PaoloJN/sensei-puck/hardware/sensei-puck/sensei-puck.kicad_pcb

## KiCad design hardware/sensei-puck/sensei-puck.kicad_pcb (2026-10-24)

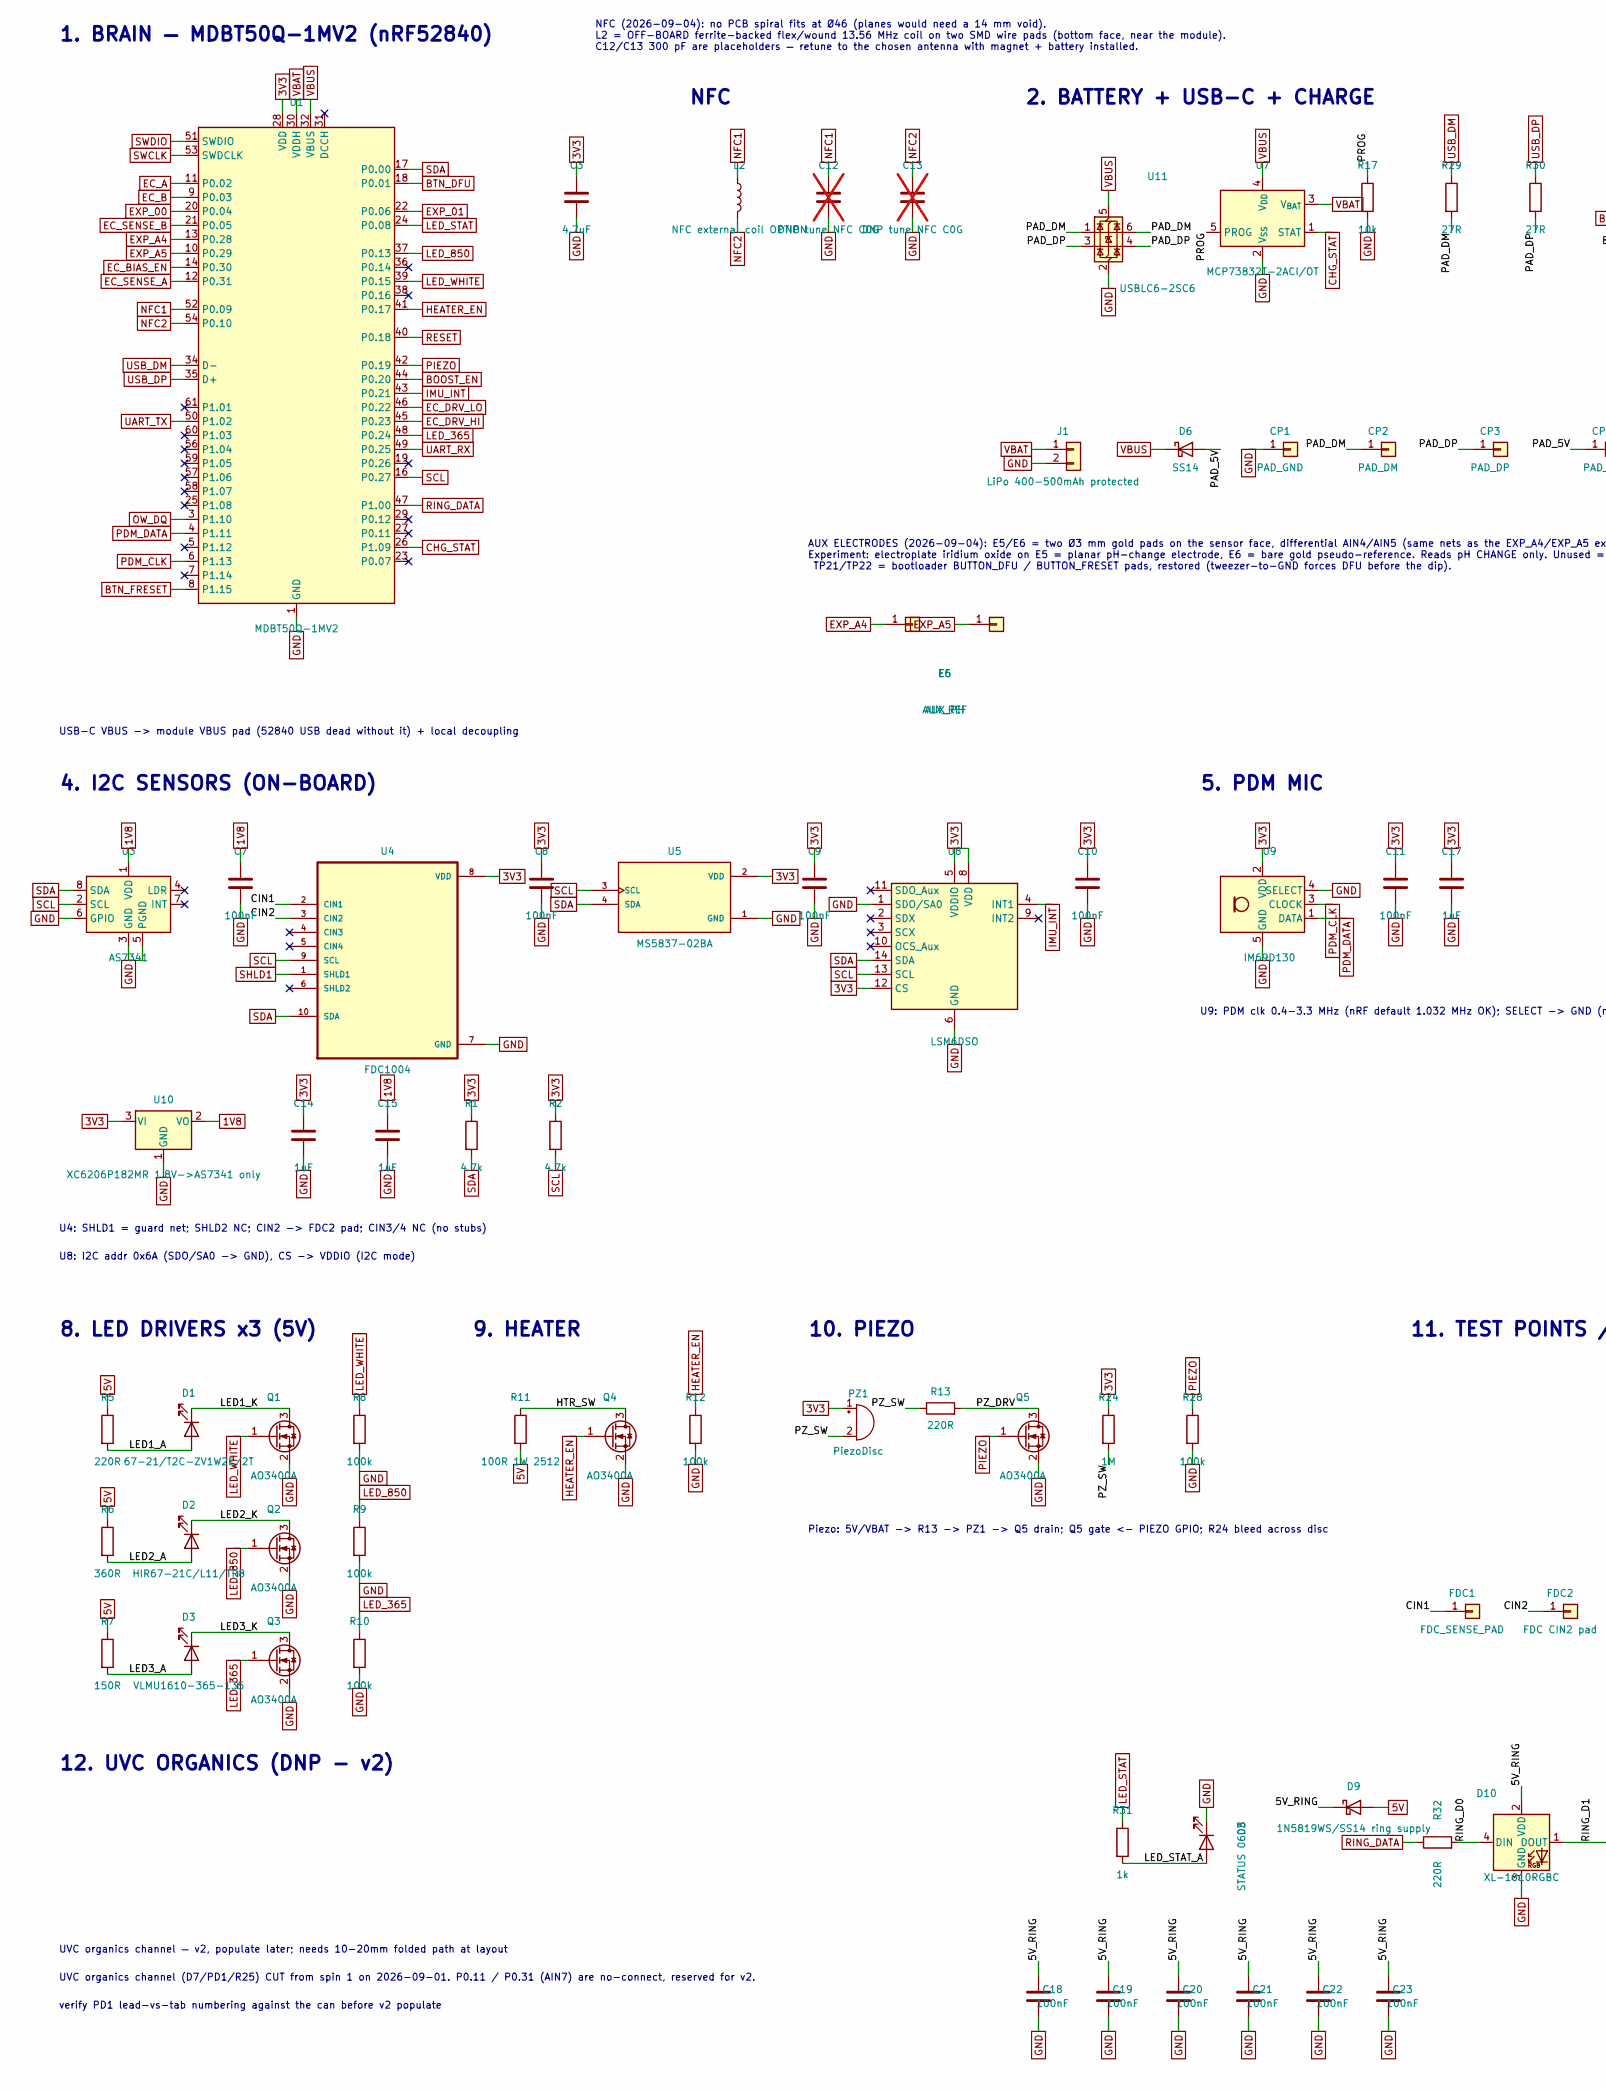
[picture p6: schematic sensei-puck.kicad_sch, part in row 1, column 1]

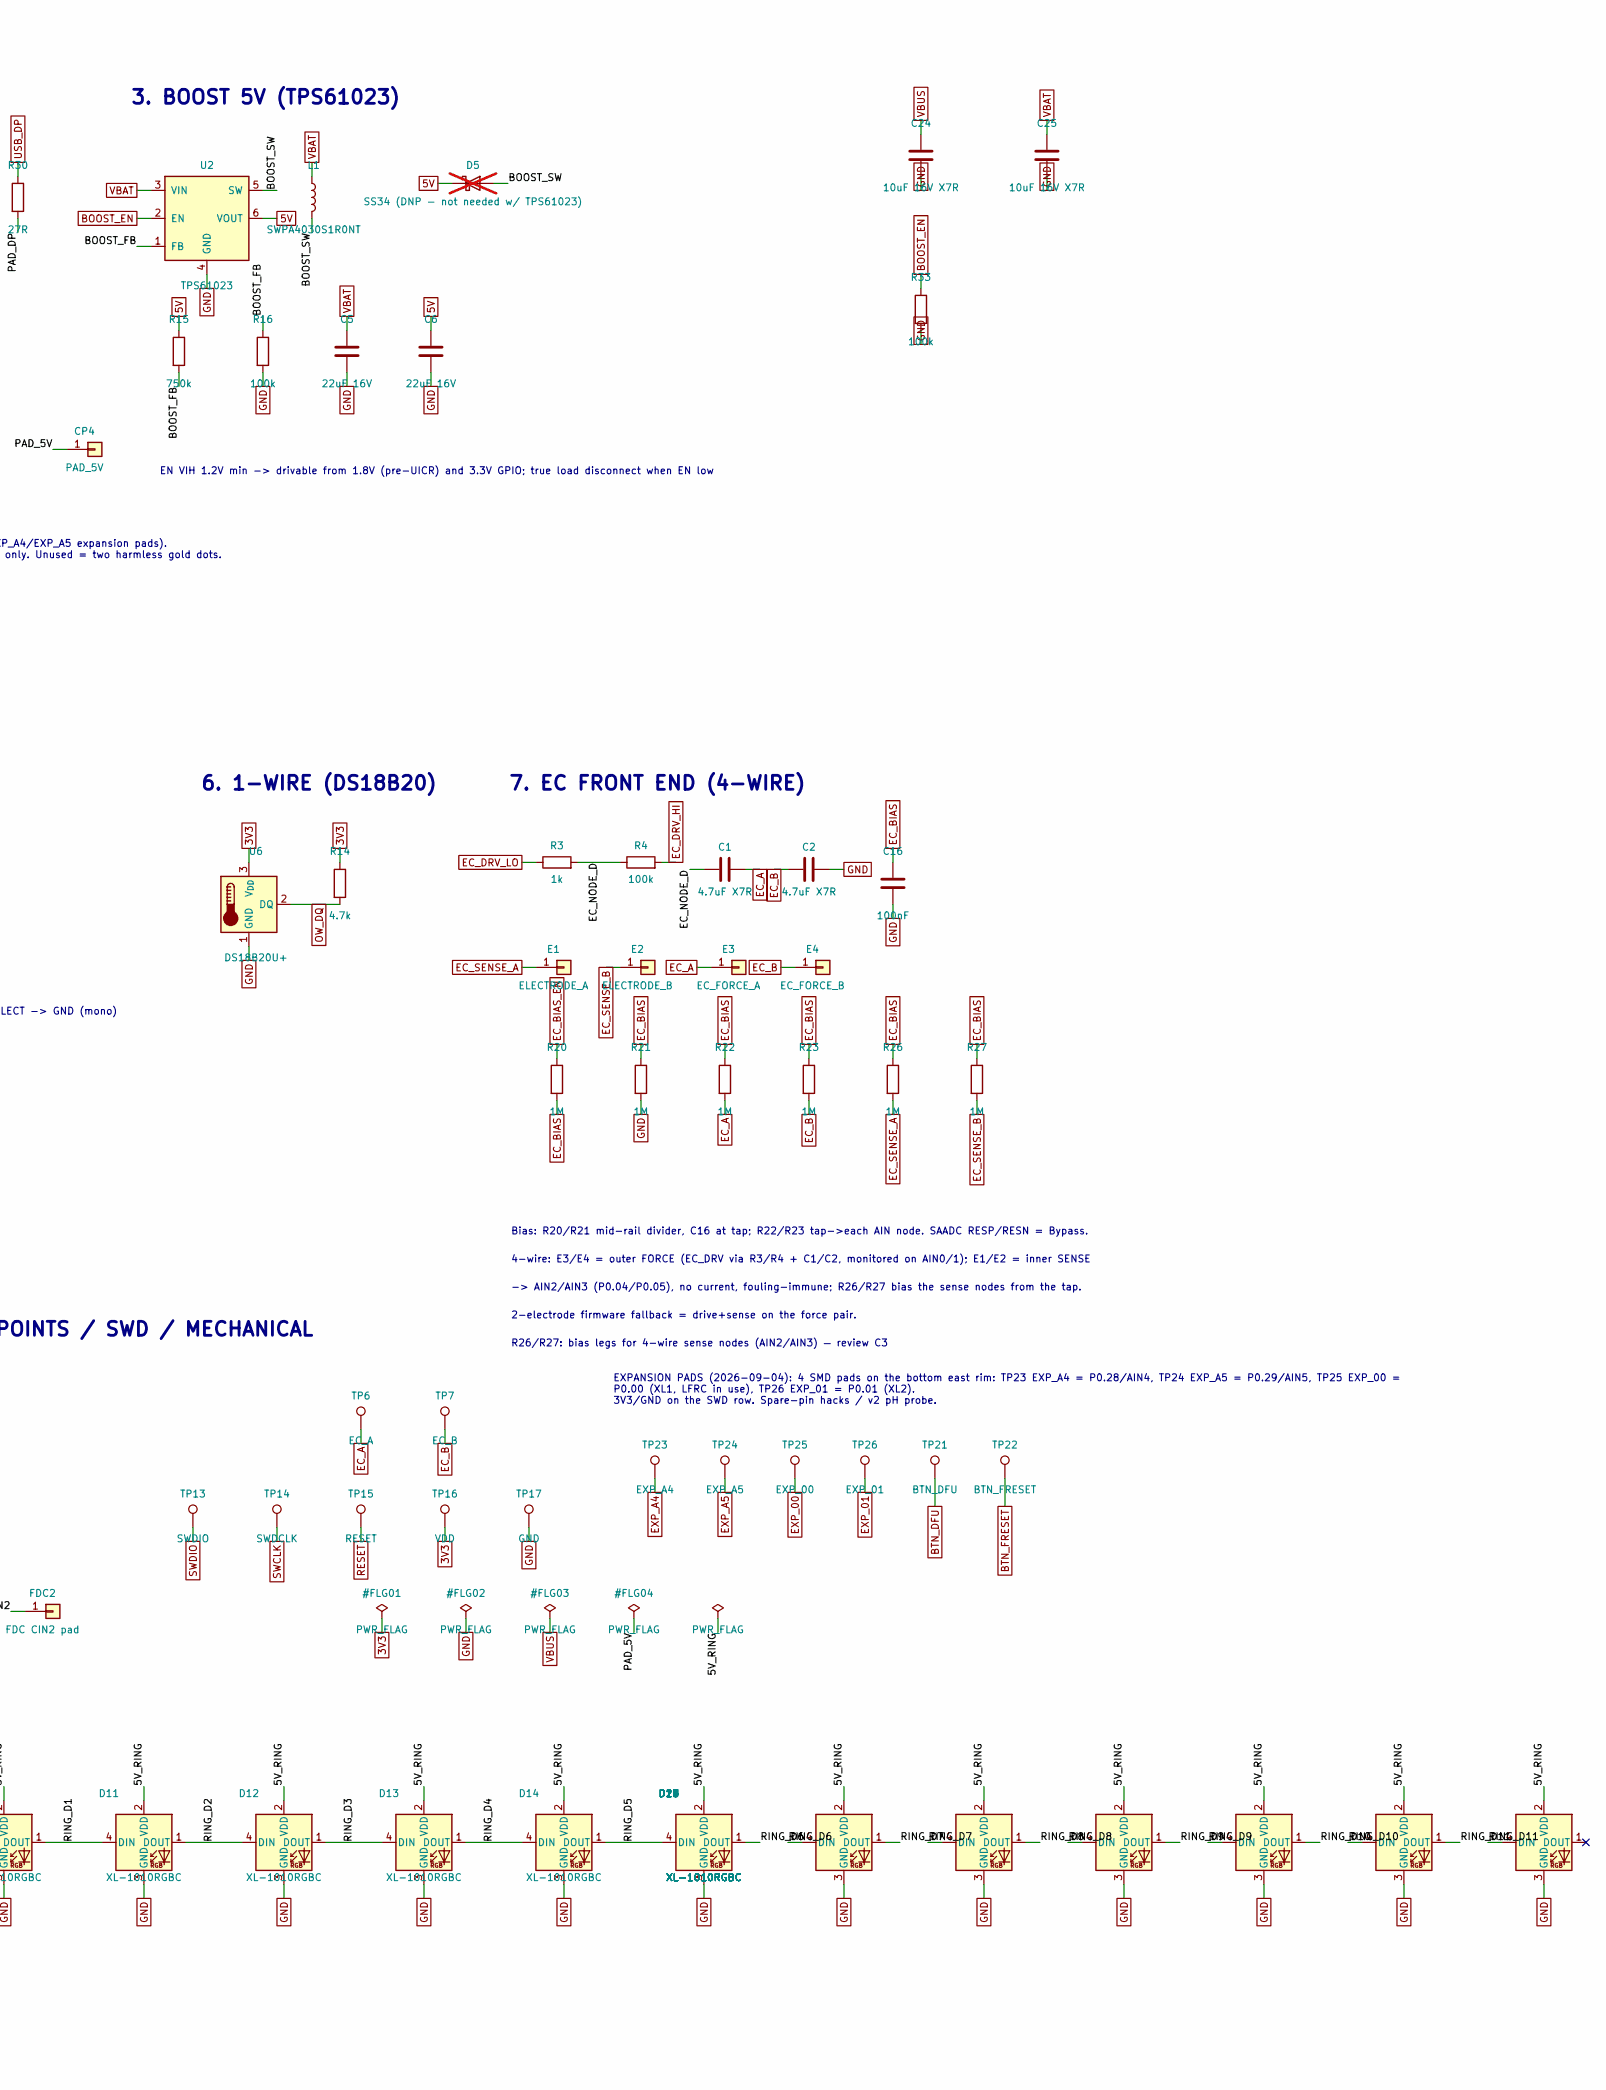
[picture p7: schematic sensei-puck.kicad_sch, part in row 1, column 2]

Parts:
C1, C2: 4.7uF X7R; C_0805_2012Metric_Pad1.18x1.45mm_HandSolder
C3: 4.7uF; C_0805_2012Metric
C5, C6: 22uF 16V; C_0805_2012Metric_Pad1.18x1.45mm_HandSolder
C7, C8, C9, C10, C11, C16, C18, C19, C20, C21, C22, C23: 100nF; C_0402_1005Metric
C12, C13: DNP tune NFC C0G; C_0402_1005Metric; not fitted
C14, C15, C17: 1uF; C_0402_1005Metric
C24, C25: 10uF 16V X7R; C_1206_3216Metric
CP1: PAD_GND; CHG_Pad_D2.0mm
CP2: PAD_DM; CHG_Pad_D2.0mm
CP3: PAD_DP; CHG_Pad_D2.0mm
CP4: PAD_5V; CHG_Pad_D2.0mm
D1: 67-21/T2C-ZV1W2E/2T; LED_Everlight_67-21_PLCC2
D2: HIR67-21C/L11/TR8; LED_Everlight_67-21_PLCC2
D3: VLMU1610-365-135; LED_Vishay_VLMU1610
D5: SS34 (DNP - not needed w/ TPS61023); D_SMA; not fitted
D6: SS14; D_SOD-123
D8: STATUS 0603; LED_0603_1608Metric
D9: 1N5819WS/SS14 ring supply; D_SOD-123
D10, D11, D12, D13, D14, D15, D16, D17, D18, D19, D20, D21: XL-1010RGBC; LED_XL-1010RGBC
E1: ELECTRODE_A; EC_Electrode_2x8mm
E2: ELECTRODE_B; EC_Electrode_2x8mm
E3: EC_FORCE_A; EC_Electrode_2x8mm
E4: EC_FORCE_B; EC_Electrode_2x8mm
E5: AUX_PH; AUX_Pad_D3.0mm
E6: AUX_REF; AUX_Pad_D3.0mm
FDC1: FDC_SENSE_PAD; FDC_Sense_Pad_D7.9mm
FDC2: FDC CIN2 pad; FDC_Sense_Ring_D10-12.8mm
J1: LiPo 400-500mAh protected; JST_PH_S2B-PH-K_1x02_P2.00mm_Horizontal
L1: SWPA4030S1R0NT; L_Sunlord_SWPA4030S
L2: NFC external coil OPTION; WirePad_1x02_SMD_1.5x3mm
PZ1: PiezoDisc; PZ_WirePad_1x02_SMD
Q1, Q2, Q3, Q4, Q5: AO3400A; SOT-23
R1, R2, R14: 4.7k; R_0402_1005Metric
R3, R31: 1k; R_0402_1005Metric
R4, R8, R9, R10, R12, R16, R28, R33: 100k; R_0402_1005Metric
R5, R13, R32: 220R; R_0402_1005Metric
R6: 360R; R_0402_1005Metric
R7: 150R; R_0402_1005Metric
R11: 100R 1W 2512; R_2512_6332Metric_Pad1.40x3.35mm_HandSolder
R15: 750k; R_0402_1005Metric
R17: 10k; R_0402_1005Metric
R20, R21, R22, R23, R24, R26, R27: 1M; R_0402_1005Metric
R29, R30: 27R; R_0402_1005Metric
TP6: EC_A; TestPoint_Pad_D1.5mm
TP7: EC_B; TestPoint_Pad_D1.5mm
TP13: SWDIO; TestPoint_Pad_D1.5mm
TP14: SWDCLK; TestPoint_Pad_D1.5mm
TP15: RESET; TestPoint_Pad_D1.5mm
TP16: VDD; TestPoint_Pad_D1.5mm
TP17: GND; TestPoint_Pad_D1.5mm
TP21: BTN_DFU; ExpPad_1.2x2.2mm
TP22: BTN_FRESET; ExpPad_1.2x2.2mm
TP23: EXP_A4; ExpPad_1.2x2.2mm
TP24: EXP_A5; ExpPad_1.2x2.2mm
TP25: EXP_00; ExpPad_1.2x2.2mm
TP26: EXP_01; ExpPad_1.2x2.2mm
U1: MDBT50Q-1MV2
U2: TPS61023; SOT-563
U3: AS7341; AMS_OLGA-8_2x3.1mm_P0.8mm
U4: FDC1004; SOP50P490X110-10N
U5: MS5837-02BA; XDCR_MS583702BA01-50
U6: DS18B20U+; DS18B20U_MSOP8
U7: MCP73832T-2ACI/OT; SOT-23-5
U8: LSM6DSO; LGA-14_3x2.5mm_P0.5mm_LayoutBorder3x4y
U9: IM69D130; Infineon_PG-LLGA-5-1
U10: XC6206P182MR 1.8V->AS7341 only; SOT-23
U11: USBLC6-2SC6; SOT-23-6

Connections:
1V8: C7.1, C15.1, U3.1 (VDD), U10.2 (VO)
3V3: C3.1, C8.1, C9.1, C10.1, C11.1, C14.1, C17.1, PZ1.1 (+), R1.1, R2.1, R14.1, R24.1, TP16.1 (1_1), U1.28 (VDD), U4.8 (VDD), U5.2 (VDD), U6.3 (V_{DD}), U8.5 (VDDIO), U8.8 (VDD), U8.12 (CS), U9.2 (VDD), U10.3 (VI)
5V: C6.1, D5.1 (K), D9.2 (A), R5.1, R6.1, R7.1, R11.2, R15.1, U2.6 (VOUT)
/5V_RING: C18.1, C19.1, C20.1, C21.1, C22.1, C23.1, D9.1 (K), D10.2 (VDD), D11.2 (VDD), D12.2 (VDD), D13.2 (VDD), D14.2 (VDD), D15.2 (VDD), D16.2 (VDD), D17.2 (VDD), D18.2 (VDD), D19.2 (VDD), D20.2 (VDD), D21.2 (VDD)
/BOOST_FB: R15.2, R16.1, U2.1 (FB)
/BOOST_SW: D5.2 (A), L1.2, U2.5 (SW)
/CIN1: FDC1.1 (Pin_1_1), U4.2 (CIN1)
/CIN2: FDC2.1 (Pin_1_1), U4.3 (CIN2)
/EC_NODE_D: C1.1, R3.2, R4.1
/HTR_SW: Q4.3 (D), R11.1
/LED1_A: D1.2 (A), R5.2
/LED1_K: D1.1 (K), Q1.3 (D)
/LED2_A: D2.2 (A), R6.2
/LED2_K: D2.1 (K), Q2.3 (D)
/LED3_A: D3.2 (A), R7.2
/LED3_K: D3.1 (K), Q3.3 (D)
/LED_STAT_A: D8.2 (A), R31.2
/PAD_5V: CP4.1 (Pin_1_1), D6.2 (A)
/PAD_DM: CP2.1 (Pin_1_1), R29.2, U11.1 (I/O1), U11.6 (I/O1)
/PAD_DP: CP3.1 (Pin_1_1), R30.2, U11.3 (I/O2), U11.4 (I/O2)
/PROG: R17.1, U7.5 (PROG)
/PZ_DRV: Q5.3 (D), R13.2
/PZ_SW: PZ1.2 (-), R13.1, R24.2
/RING_D0: D10.4 (DIN), R32.2
/RING_D1: D10.1 (DOUT), D11.4 (DIN)
/RING_D2: D11.1 (DOUT), D12.4 (DIN)
/RING_D3: D12.1 (DOUT), D13.4 (DIN)
/RING_D4: D13.1 (DOUT), D14.4 (DIN)
/RING_D5: D14.1 (DOUT), D15.4 (DIN)
/RING_D6: D15.1 (DOUT), D16.4 (DIN)
/RING_D7: D16.1 (DOUT), D17.4 (DIN)
/RING_D8: D17.1 (DOUT), D18.4 (DIN)
/RING_D9: D18.1 (DOUT), D19.4 (DIN)
/RING_D10: D19.1 (DOUT), D20.4 (DIN)
/RING_D11: D20.1 (DOUT), D21.4 (DIN)
BOOST_EN: R33.1, U1.44 (P0.20), U2.2 (EN)
BTN_DFU: TP21.1 (1_1), U1.18 (P0.01)
BTN_FRESET: TP22.1 (1_1), U1.8 (P1.15)
CHG_STAT: U1.26 (P1.09), U7.1 (STAT)
EC_A: C1.2, E3.1 (Pin_1_1), R22.2, TP6.1 (1_1), U1.11 (P0.02)
EC_B: C2.1, E4.1 (Pin_1_1), R23.2, TP7.1 (1_1), U1.9 (P0.03)
EC_BIAS: C16.1, R20.2, R21.1, R22.1, R23.1, R26.1, R27.1
EC_BIAS_EN: R20.1, U1.14 (P0.30)
EC_DRV_HI: R4.2, U1.45 (P0.23)
EC_DRV_LO: R3.1, U1.46 (P0.22)
EC_SENSE_A: E1.1 (Pin_1_1), R26.2, U1.12 (P0.31)
EC_SENSE_B: E2.1 (Pin_1_1), R27.2, U1.21 (P0.05)
EXP_00: TP25.1, U1.20 (P0.04)
EXP_01: TP26.1, U1.22 (P0.06)
EXP_A4: E5.1 (Pin_1_1), TP23.1, U1.13 (P0.28)
EXP_A5: E6.1 (Pin_1_1), TP24.1, U1.10 (P0.29)
GND: C2.2, C3.2, C5.2, C6.2, C7.2, C8.2, C9.2, C10.2, C11.2, C12.2, C13.2, C14.2, C15.2, C16.2, C17.2, C18.2, C19.2, C20.2, C21.2, C22.2, C23.2, C24.2, C25.2, CP1.1 (Pin_1_1), D8.1 (K), D10.3 (GND), D11.3 (GND), D12.3 (GND), D13.3 (GND), D14.3 (GND), D15.3 (GND), D16.3 (GND), D17.3 (GND), D18.3 (GND), D19.3 (GND), D20.3 (GND), D21.3 (GND), J1.2, Q1.2 (S), Q2.2 (S), Q3.2 (S), Q4.2 (S), Q5.2 (S), R8.2, R9.2, R10.2, R12.2, R16.2, R17.2, R21.2, R28.2, R33.2, TP17.1 (1_1), U1.1 (GND), U1.2 (GND), U1.15 (GND), U1.33 (GND), U1.55 (GND), U2.4 (GND), U3.3 (GND), U3.5 (PGND), U3.6 (GPIO), U4.7 (GND), U5.1 (GND), U6.1 (GND), U7.2 (V_{SS}), U8.1 (SDO/SA0), U8.6 (GND), U8.7 (GND), U9.4 (SELECT), U9.5 (GND), U10.1 (GND), U11.2 (GND)
HEATER_EN: Q4.1 (G), R12.1, U1.41 (P0.17)
IMU_INT: U1.43 (P0.21), U8.4 (INT1)
LED_365: Q3.1 (G), R10.1, U1.48 (P0.24)
LED_850: Q2.1 (G), R9.1, U1.37 (P0.13)
LED_STAT: R31.1, U1.24 (P0.08)
LED_WHITE: Q1.1 (G), R8.1, U1.39 (P0.15)
NFC1: C12.1, L2.1, U1.52 (P0.09)
NFC2: C13.1, L2.2, U1.54 (P0.10)
OW_DQ: R14.2, U1.3 (P1.10), U6.2 (DQ)
PDM_CLK: U1.6 (P1.13), U9.3 (CLOCK)
PDM_DATA: U1.4 (P1.11), U9.1 (DATA)
PIEZO: Q5.1 (G), R28.1, U1.42 (P0.19)
RESET: TP15.1 (1_1), U1.40 (P0.18)
RING_DATA: R32.1, U1.47 (P1.00)
SCL: R2.2, U1.16 (P0.27), U3.2 (SCL), U4.9 (SCL), U5.3 (SCL), U8.13 (SCL)
SDA: R1.2, U1.17 (P0.00), U3.8 (SDA), U4.10 (SDA), U5.4 (SDA), U8.14 (SDA)
SHLD1: U4.1 (SHLD1)
SWCLK: TP14.1 (1_1), U1.53 (SWDCLK)
SWDIO: TP13.1 (1_1), U1.51 (SWDIO)
UART_RX: U1.49 (P0.25)
UART_TX: U1.50 (P1.02)
USB_DM: R29.1, U1.34 (D-)
USB_DP: R30.1, U1.35 (D+)
VBAT: C5.1, C25.1, J1.1, L1.1, U1.30 (VDDH), U2.3 (VIN), U7.3 (V_{BAT})
VBUS: C24.1, D6.1 (K), U1.32 (VBUS), U7.4 (V_{DD}), U11.5 (VBUS)

Notes on the sheet:
7. EC FRONT END (4-WIRE)
9. HEATER
5. PDM MIC
-> AIN2/AIN3 (P0.04/P0.05), no current, fouling-immune; R26/R27 bias the sense nodes from the tap.
10. PIEZO
2-electrode firmware fallback = drive+sense on the force pair.
Bias: R20/R21 mid-rail divider, C16 at tap; R22/R23 tap->each AIN node. SAADC RESP/RESN = Bypass.
6. 1-WIRE (DS18B20)
verify PD1 lead-vs-tab numbering against the can before v2 populate
4. I2C SENSORS (ON-BOARD)
UVC organics channel (D7/PD1/R25) CUT from spin 1 on 2026-09-01. P0.11 / P0.31 (AIN7) are no-connect, reserved for v2.
NFC (2026-09-04): no PCB spiral fits at Ø46 (planes would need a 14 mm void). L2 = OFF-BOARD ferrite-backed flex/wound 13.56 MHz coil on two SMD wire pads (bottom face, near the module). C12/C13 300 pF are placeholders — retune to the chosen antenna with magnet + battery installed.
1. BRAIN — MDBT50Q-1MV2 (nRF52840)
UVC organics channel — v2, populate later; needs 10-20mm folded path at layout
NFC
R26/R27: bias legs for 4-wire sense nodes (AIN2/AIN3) — review C3
U8: I2C addr 0x6A (SDO/SA0 -> GND), CS -> VDDIO (I2C mode)
U9: PDM clk 0.4-3.3 MHz (nRF default 1.032 MHz OK); SELECT -> GND (mono)
EN VIH 1.2V min -> drivable from 1.8V (pre-UICR) and 3.3V GPIO; true load disconnect when EN low
AUX ELECTRODES (2026-09-04): E5/E6 = two Ø3 mm gold pads on the sensor face, differential AIN4/AIN5 (same nets as the EXP_A4/EXP_A5 expansion pads). Experiment: electroplate iridium oxide on E5 = planar pH-change electrode, E6 = bare gold pseudo-reference. Reads pH CHANGE only. Unused = two harmles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
8. LED DRIVERS x3 (5V)
USB-C VBUS -> module VBUS pad (52840 USB dead without it) + local decoupling
Piezo: 5V/VBAT -> R13 -> PZ1 -> Q5 drain; Q5 gate <- PIEZO GPIO; R24 bleed across disc
EXPANSION PADS (2026-09-04): 4 SMD pads on the bottom east rim: TP23 EXP_A4 = P0.28/AIN4, TP24 EXP_A5 = P0.29/AIN5, TP25 EXP_00 = P0.00 (XL1, LFRC in use), TP26 EXP_01 = P0.01 (XL2). 3V3/GND on the SWD row. Spare-pin hacks / v2 pH probe.
12. UVC ORGANICS (DNP - v2)
3. BOOST 5V (TPS61023)
4-wire: E3/E4 = outer FORCE (EC_DRV via R3/R4 + C1/C2, monitored on AIN0/1); E1/E2 = inner SENSE
2. BATTERY + USB-C + CHARGE
U4: SHLD1 = guard net; SHLD2 NC; CIN2 -> FDC2 pad; CIN3/4 NC (no stubs)
11. TEST POINTS / SWD / MECHANICAL

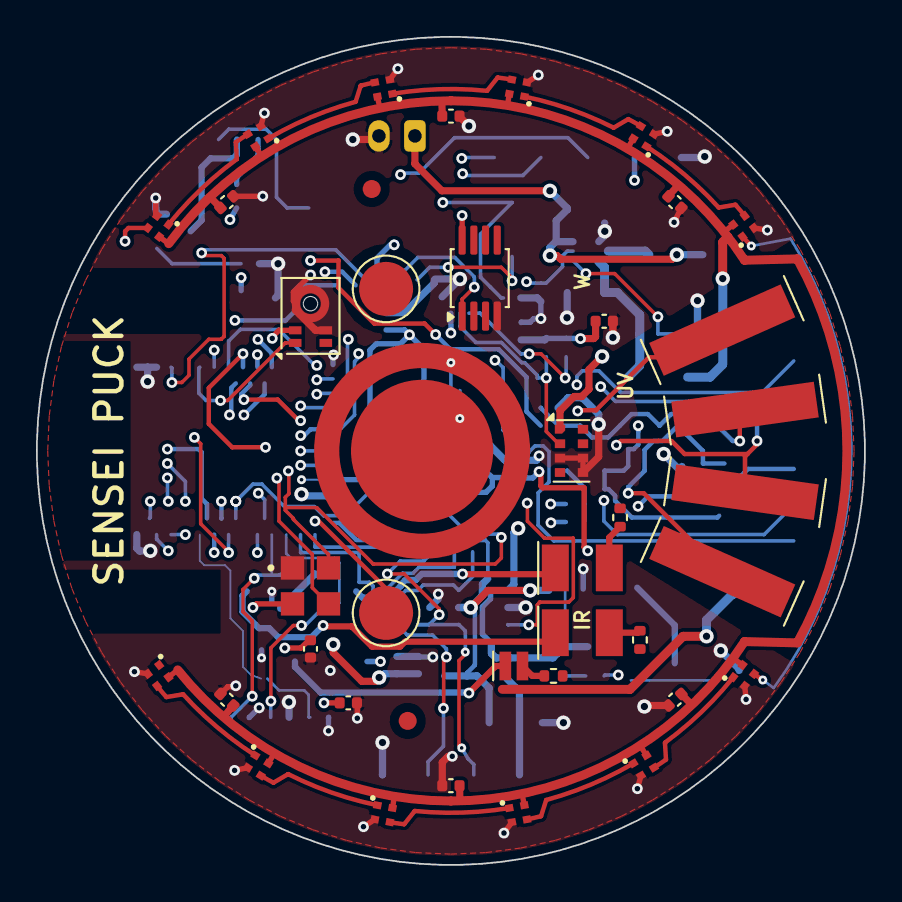
[picture p8: board sensei-puck.kicad_pcb from above]

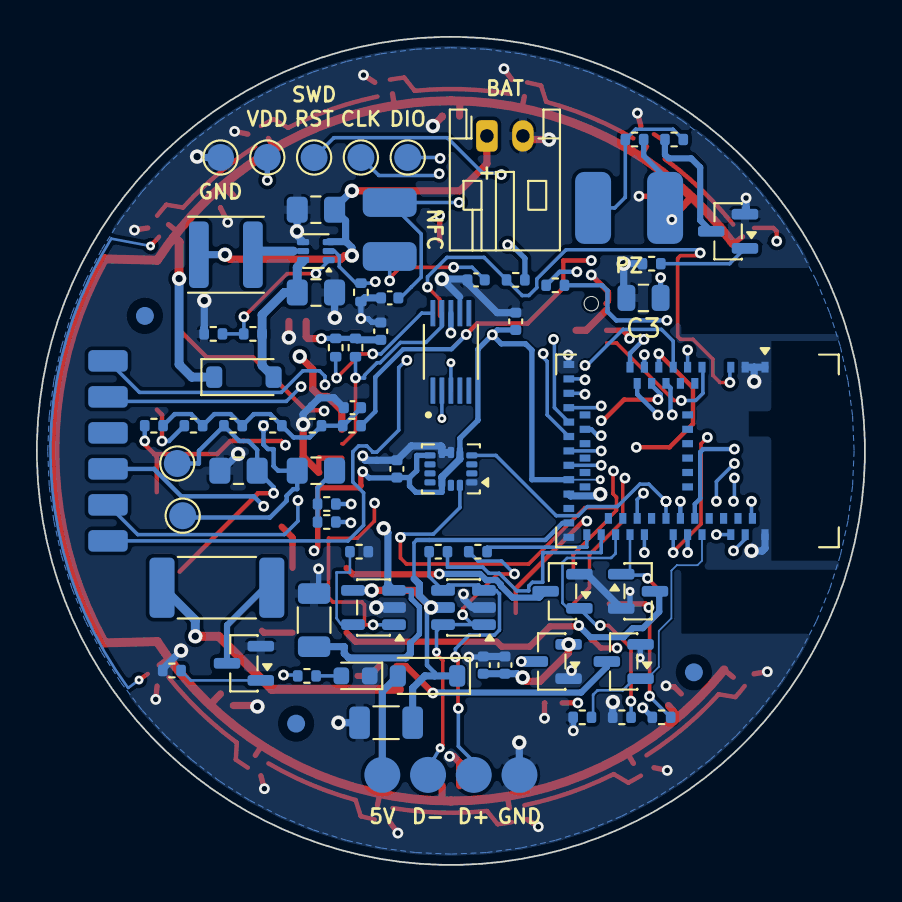
[picture p9: board sensei-puck.kicad_pcb from below]

Board: 4 copper layers, 46.0 x 46.0 mm, 122 parts (81 on the bottom side), 74 nets.

Other parts of the board:
FID3, FID4, FID5, FID6, FID7: FIDUCIAL; Fiducial_1mm_Mask2mm
