PaoloJN/sensei-puck/(commit log)

2026-10-11 Baseline after Codex revision pass 2026-10-11
    Whole tree as it stands: Codex's charger/EC-bias/dock/LED-footprint
    fixes, rewritten docs, firmware startup guards, and the unfinished
    routed board (130 unconnected). See docs/changelog.md 2026-10-11.
    [engineering-bom.csv, puck-carrier-3d.step, puck-carrier.kicad_pcb, puck-carrier.kicad_sch, puck-resin-body.stl]
2026-10-11 Routing pass: 130 -> 19 signal opens, 0 DRC errors
    Scripted 3V3 fan-out, hand routes under the FDC pads, Freerouting rounds on
    a filtered router view (scripts/router). GND/3V3 pours now fragmented (21/9
    islands); 19 signal connections still open, listed in the changelog.
    [puck-carrier.kicad_pcb]
2026-10-12 Routing: 49 -> 28 unconnected, grid router tools, Codex evening pass logged
    Move the module 3V3 trunk off the east pad column, route EC_A and EC_BIAS,
    bridge the 3V3 plane pieces, stitch 16 GND islands. 0 DRC errors, parity 0.
    Add geom_export/grid_router/apply_plans/gnd_stitch/plot_region and the
    strip/riploop/pin_swap helpers; record every strategy that plateaued.
    [puck-carrier.kicad_pcb]
2026-10-12 Round PCB traces and repair USB, battery and 3V3 connections
    Preserve the original full-feature layout. Verify zero DRC violations and schematic mismatches, with 21 opens still outstanding; this is not a fabrication release. Fix raster connectivity and project-aware geometry export, and refresh reports and previews.
    [puck-carrier.kicad_pcb]
2026-10-24 Checkpoint before archive cleanup: v2 board, routes, research notes, pin-swap variant
    [puck-carrier-v2.kicad_pcb, puck-carrier-v2.kicad_sch, puck-carrier.kicad_pcb]
2026-10-24 Archive as Sensei Puck: keep v2 board, firmware and spec; drop notes, v1 board, datasheets and scratch
    Project stopped before the first board order. README now explains the
    design, its state and why it was abandoned. Decision log, changelog, research
    notes and the v1 layout remain in history before this commit.
    [engineering-bom.csv, puck-carrier-3d.step, puck-carrier-v2.kicad_pcb, puck-carrier-v2.kicad_sch, puck-carrier.kicad_pcb, puck-carrier.kicad_sch, puck-resin-body.stl, sensei-puck.kicad_pcb]
2026-10-24 README: KiCad screenshot on top, renders and concept moved to a gallery
